Gromatou/moineau-Frame-2.5p/README.md

# moineau-Frame-2.5p — Light & Durable 2.5" FPV Frame
**(alias: how to make the PERFECT tiny FPV quad)**

## Key Features
- **Take advantage of the carbon fiber**: engineered specifically for carbon fiber mechanical properties.
- **Full component protection**: Compact structure that perfectly shields 25×25 AIOs and lite HD VTX.
- **Ultra-light**: Carbon parts weigh about 11g, and the hardware (12 screws, 4 nuts, and 4 standoffs) weighs about 2.5g.
- **Camera mount compatibility**: Fully supports all **KayouMini TPU "Camera Mounts"**.

---

## usefull guides : 
components choice guide

wich tpu is for you, and what settigns should you use to print thems

how to buy this frame, and what to ask if you want the best result

**Grognatiny** is an **original creation**. Only the dimensions of KayouMini camera TPU mounts were used to ensure perfect compatibility.

---

##  License  
This project is distributed under a CC BY-NC 4.0 license  
https://creativecommons.org/licenses/by-nc/4.0/?hl=fr-FR

The only entities authorized to resell, distribute, or use this project for commercial purposes are:

- Carbon fiber cutters on demand within the European Union
- My "alouette" shop on thrusthover.fr
(if you want to be added on this list you can ask me on discord "grognatou"
