Gromatou/moineau-Frame-2.5p/pictures/flywoo-lipo.png

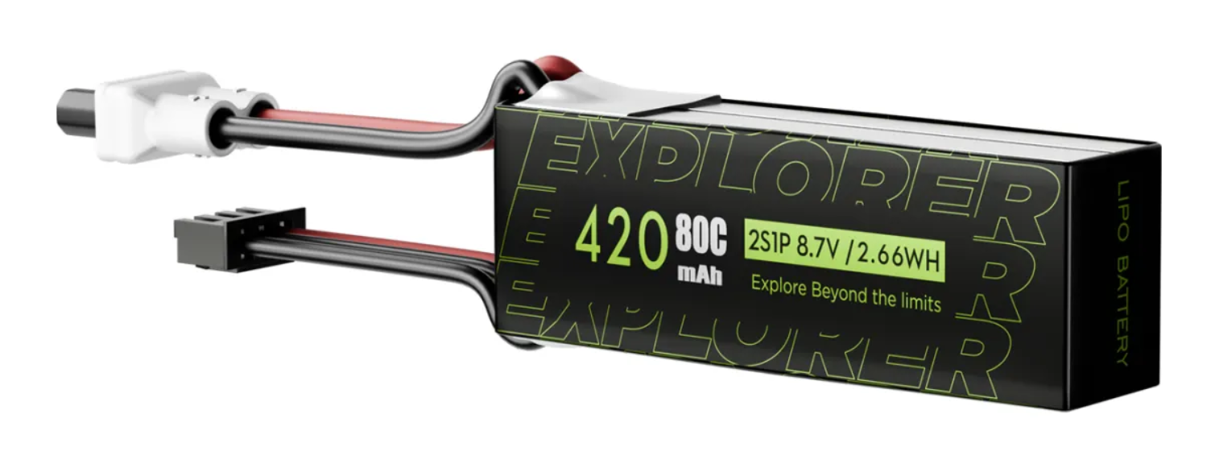
pictures/flywoo-lipo.png
