Gromatou/moineau-Frame-2.5p/pictures/GNB-lipo.png

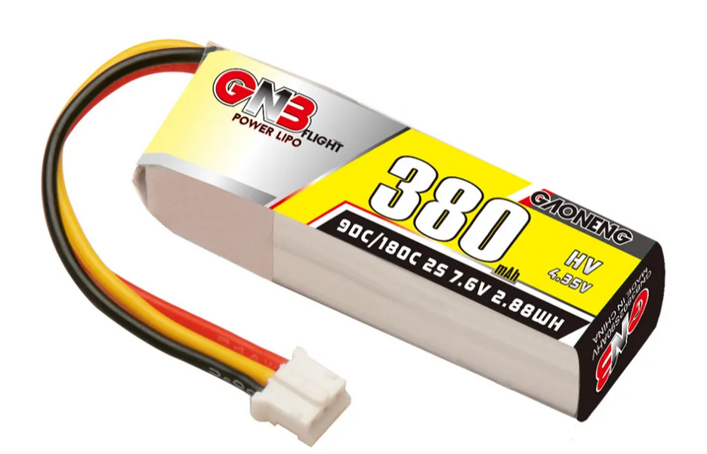
pictures/GNB-lipo.png
