Gromatou/moineau-Frame-2.5p/recommended-components.md

# Recommended Components

##  Motors  
You can choose any motor with these specs: 6500KV–9000KV, 1103  

### 22€ (4pcs) — **Surpasshobby**: 3.6g, 8000KV; good for an analog build  
surpasshobby
https://fr.aliexpress.com/item/1005008163135913.html

### 28€ (4pcs) — **Sparkhobby**: 4.5g, 8500KV; very strong, more KV, ideal for HD  
sparkhobby
https://fr.aliexpress.com/item/1005009184817863.html

### 22€ (4pcs) — **ysido**: 3.6g, 8500KV; light, cheap, widely available, but not aesthetic  
ysido
https://fr.aliexpress.com/item/1005006640914306.html

---

##  VTX, Camera & AIOs  
**Requirement:** lightweight components

###  Analog  
You can use an AIO with integrated VTX:

- **55€ — JHEMCU ELVTX**: 5g, 12A ESC, 400mW VTX; a cheap 5-in-1 AIO  
  elvtx  
  https://fr.aliexpress.com/item/1005009013813390.html

- **70€ — Ysido**: 5g, 12-20A ESC, 400mW VTX; verry good pads, clean layout, am32, blackbox  
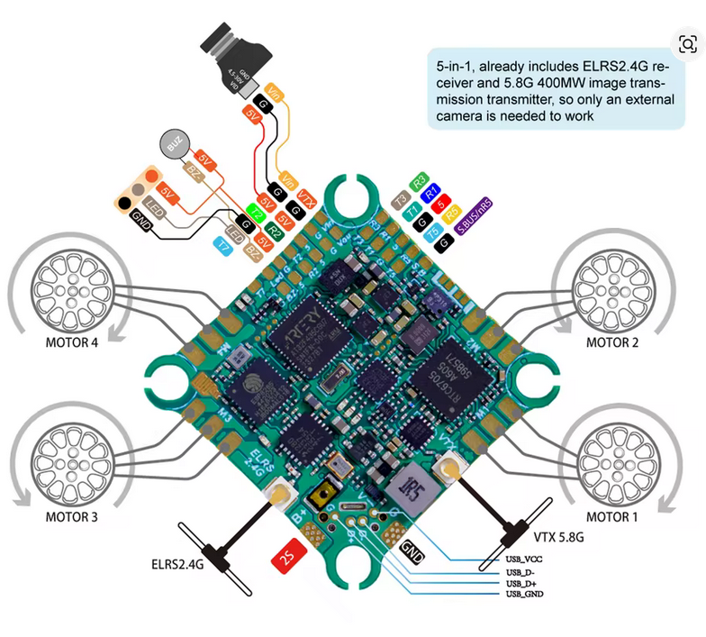
[picture p3: pictures/aio-ysido.png]
ysdio-aio
    
  https://fr.aliexpress.com/item/1005006712888748.html

- **25€ — Caddx Baby Ratel 2**: 3.5g, 165° FOV; night flight capable, best analog cam  
  bbr2  
  https://fr.aliexpress.com/item/1005009014429309.html

- **17€ — BetaFPV C03**: 1.1g, 155° FOV; save 2g and 2€, good daylight cam  
  co3  
  https://fr.aliexpress.com/item/1005007644657307.html

---

###  HDZero  
- **100€ — AIO15**: Be a goat and choose this AIO to fly like analog pilots  
  AIO15  
  https://www.hd-zero.com/product-page/hdzero-aio15

---

###  HD VTX  
You fly HD? Choose one of these VTX modules:

- **105€ — DJI O4 (lite)**: 8.5g including cam  
  o4lite  
  https://store.dji.com/fr/product/dji-o4-air-unit

- **90€ — Walksnail Avatar HD Mini**: 5.1g  
  avatar  
  https://caddxfpv.com/products/walksnail-avatar-hd-mini-1s-lite-kit

---

###  HD AIO (without integrated VTX)
You still need to stay lightweight:

- **JHEMCU ELRS**: 5g, 12A ESC, ELRS  
  jhemcu elrs  
  https://fr.aliexpress.com/item/1005007805656123.html

- **JHEMCU F435**: 5g, 20A ESC, ELRS  
  jhemcu f435  
  https://fr.aliexpress.com/item/1005007942847361.html

---

##  Battery Choices  
Which LiPo and charger should you buy?  
I realy recommand the bt3 mod on your lipos, it make them lighter, eazier to charge, and you dont carry a balance plug anymore!
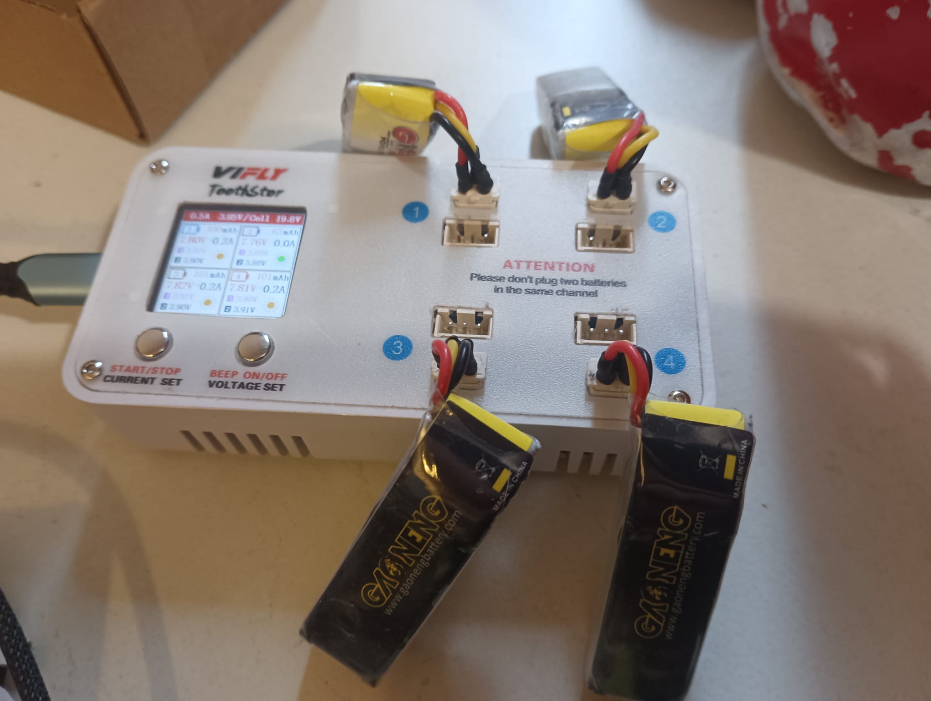
[picture p4: pictures/toothstore-bt3-GNB.jpg]
bt3 charger
    

https://www.gaoneng.shop/products/gaoneng-gnb-lihv-2s-7.6v-380mah-90c-lipo-battery-ph2.0-3pin-connector
With thoses, the bt3 mod is verry eazy to do, and they are verry cheap
