Gromatou/moineau-Frame-2.5p/frame/Bottom plate V2.dxf

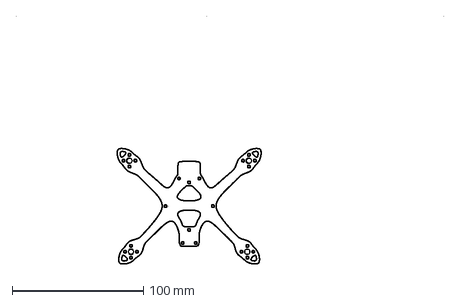
[picture p5: CAD file, 2026-05-31]
frame/Bottom plate V2.dxf
325.0 x 188.6 mm
