Gromatou/moineau-Frame-2.5p/tpu/Moineau batterystrap - alternative for xt30 lipos.3mf

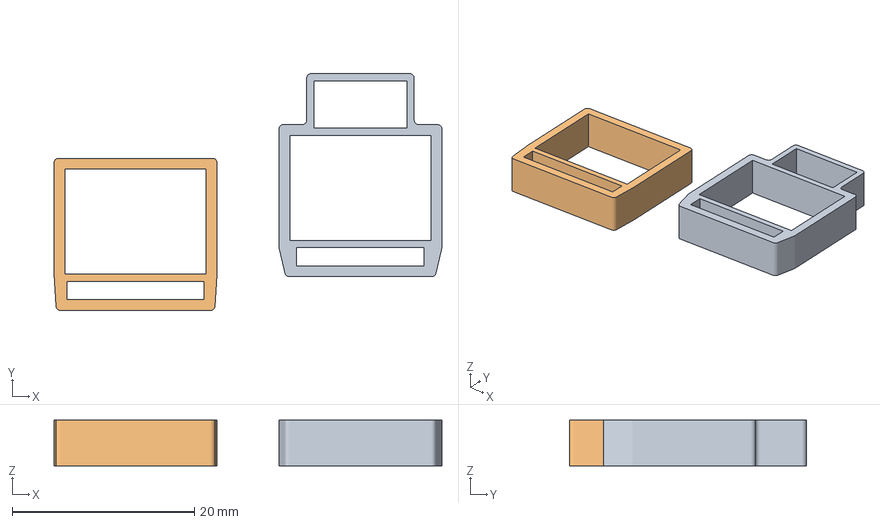
[picture p6: CAD file, 2026-07-15]
tpu/Moineau batterystrap - alternative for xt30 lipos.3mf
42.6 x 26.0 x 5.00 mm
Kayoumini batterystrap - back
Kayoumini batterystrap - front
