Gromatou/moineau-Frame-2.5p/frame/moineau-top-2mm.dxf

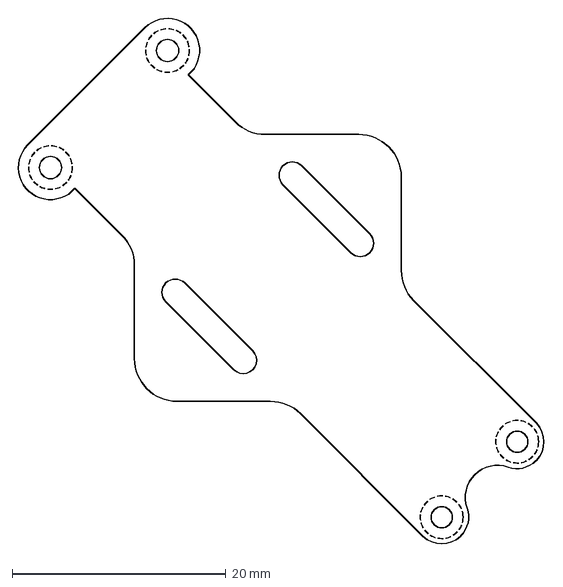
[picture p7: CAD file, 2025-12-13]
frame/moineau-top-2mm.dxf
49.6 x 49.6 mm
