Gromatou/moineau-Frame-2.5p/tpu/backback antenna inside.3mf

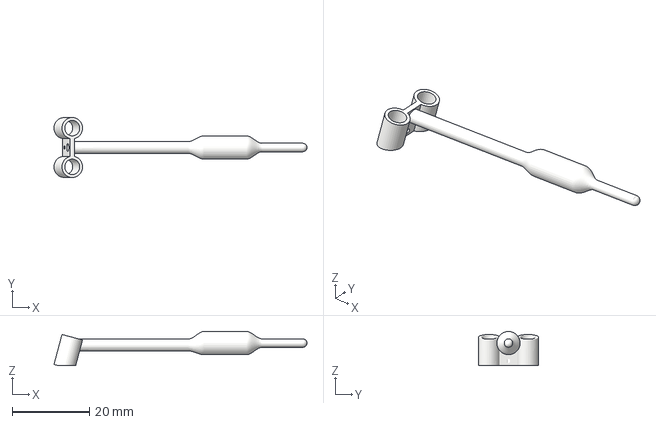
[picture p8: CAD file, 2026-06-11]
tpu/backback antenna inside.3mf
65.3 x 15.5 x 8.78 mm
