Gromatou/moineau-Frame-2.5p/tpu/backpack antenna inside bt3.3mf

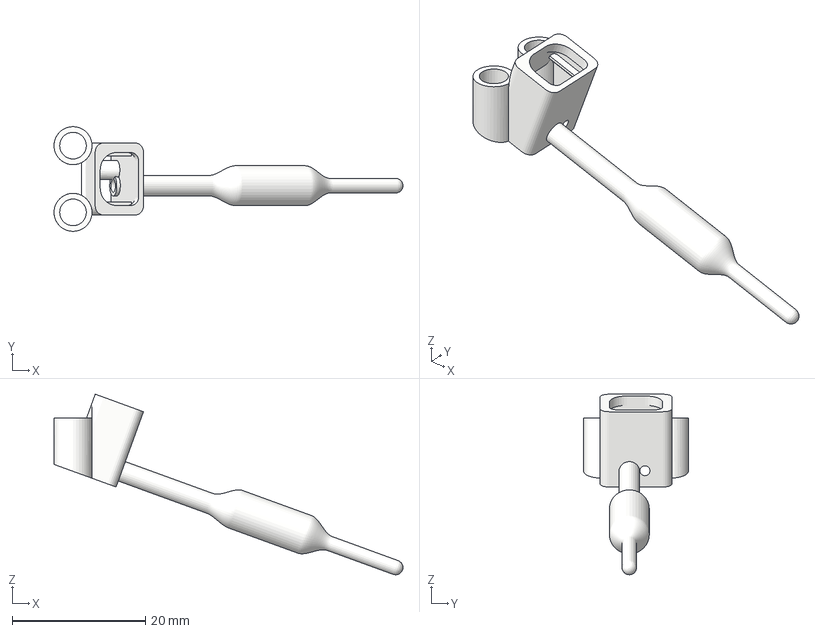
[picture p9: CAD file, 2026-06-11]
tpu/backpack antenna inside bt3.3mf
52.3 x 15.7 x 27.1 mm
