Gromatou/moineau-Frame-2.5p/tpu/Heavy Arms bumper moineau.stp

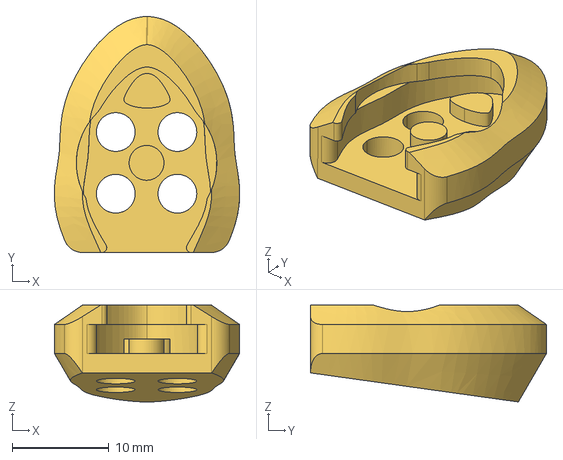
[picture p10: CAD file, 2026-06-11]
tpu/Heavy Arms bumper moineau.stp
19.1 x 24.4 x 10.0 mm
