Gromatou/moineau-Frame-2.5p/tpu/base backpack.3mf

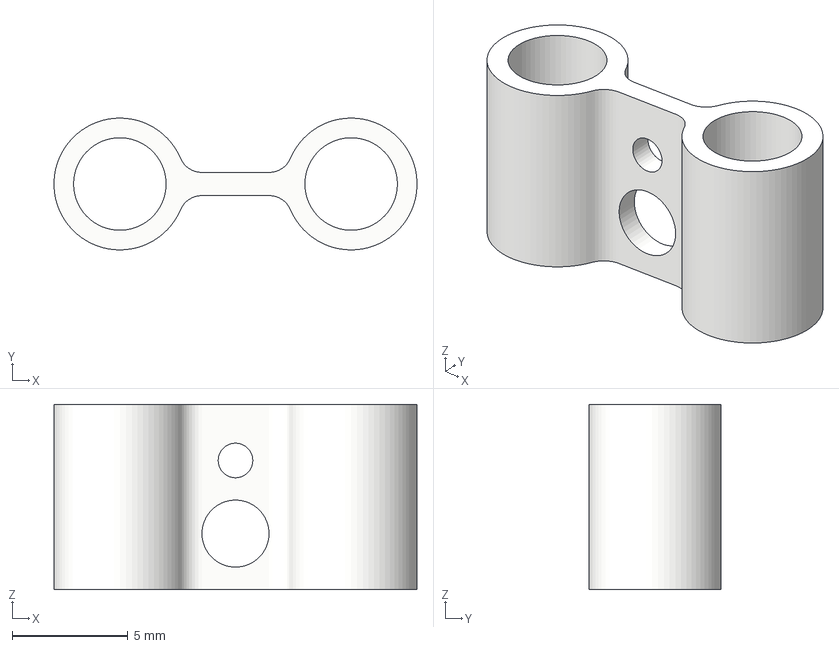
[picture p11: CAD file, 2026-05-31]
tpu/base backpack.3mf
15.7 x 5.70 x 8.00 mm
