Gromatou/moineau-Frame-2.5p/tpu/Backpack BT3 moineau.3mf

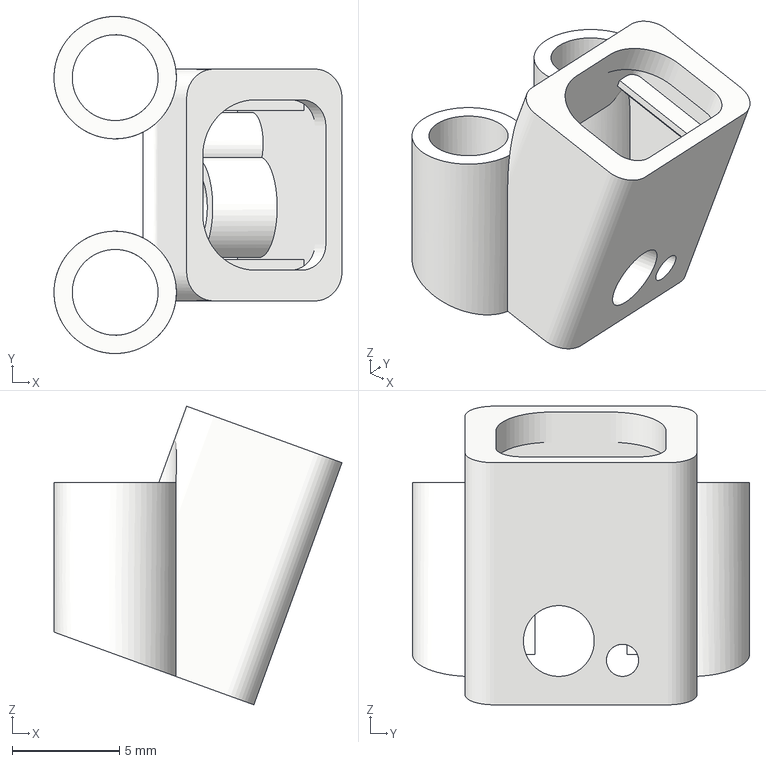
[picture p12: CAD file, 2026-05-31]
tpu/Backpack BT3 moineau.3mf
13.4 x 15.7 x 13.9 mm
