Gromatou/moineau-Frame-2.5p/tpu/Arms bumper moineau.3mf

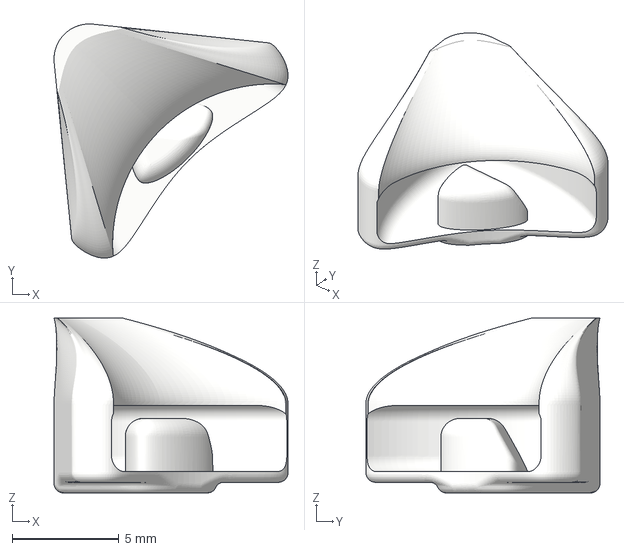
[picture p13: CAD file, 2026-05-31]
tpu/Arms bumper moineau.3mf
11.0 x 11.0 x 8.20 mm
