Gromatou/moineau-Frame-2.5p/tpu/battery strap 110% scale recommanded.3mf

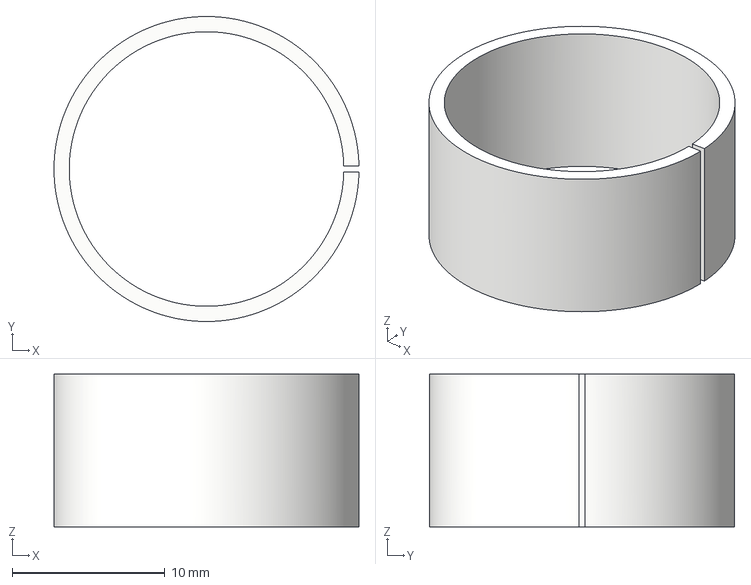
[picture p14: CAD file, 2026-02-08]
tpu/battery strap 110% scale recommanded.3mf
20.0 x 20.0 x 10.0 mm
