Gromatou/moineau-Frame-2.5p/tpu/backpack moineau.3mf

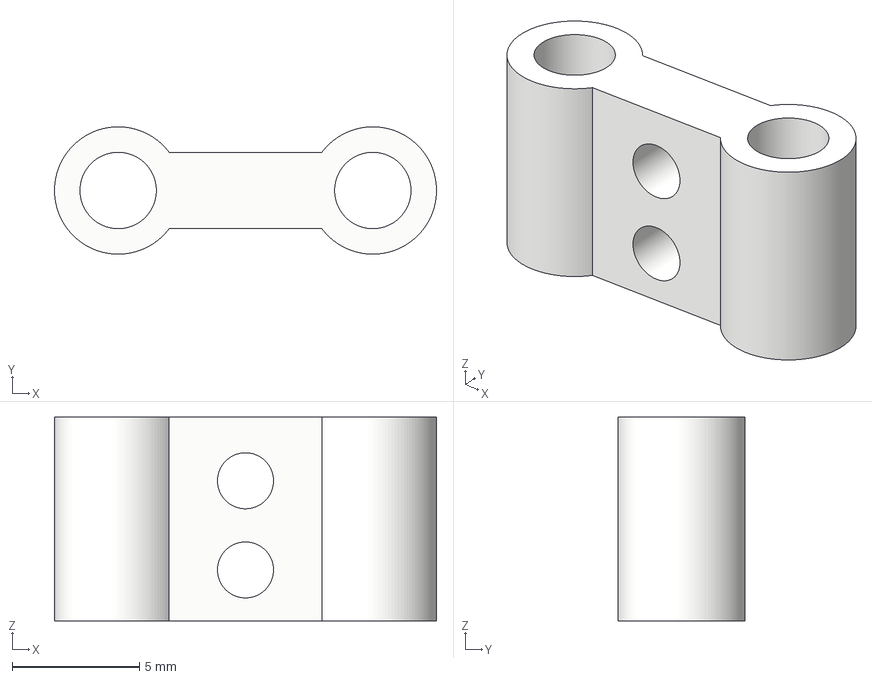
[picture p15: CAD file, 2025-12-07]
tpu/backpack moineau.3mf
15.0 x 5.00 x 8.00 mm
