Gromatou/moineau-Frame-2.5p/(commit log)

2025-12-02 Update battery choices recommendation
    Corrected recommendation for LiPo battery modification.
2025-12-03 Add carbon frame guide and update component images
    Added carbon-manufacturing-and-screws.md with frame manufacturing and screw selection instructions. Updated recommended-components.md to replace Happymodel X12 references with Ysido, adjusted motor listings, and improved battery recommendations. Added new images for Ysido AIO, GNB LiPo, Flywoo LiPo, and BT3 mod; removed Happymodel X12 image.
2025-12-07 Update and reorganize TPU 3D model files
    Added new 3D models for battery, backpack, and connector components. Removed outdated battery and backpack files, and renamed battery_350-380mah.3mf.3mf to battery_420-450mah.3mf for clarity. Updated arms bumper model.
    [350-420.3mf, arms bumper - grognatiny .3mf, arms bumper - moineau.3mf, backpack - grognatiny.3mf, backpack moineau 2 (long antenna).3mf, backpack moineau.3mf, battery-260-300.3mf, battery_280-350mah.3mf]
2025-12-07 Rename frame files to Moineau and update manufacturing instructions
    - Rename grognatiny.f3d to moineau.f3d
    - Rename bottom_plate.dxf to moineau-bottom-3mm.dxf
    - Rename top_plate.dxf to moineau-top-2mm.dxf
    - Update carbon-manufacturing-instructions.md
    [bottom_plate.dxf, grognatiny.f3d, moineau-bottom-3mm.dxf, moineau-top-2mm.dxf, moineau.f3d, top_plate.dxf]
2025-12-07 Update link to carbon manufacturing instructions
    Changed the referenced file from 'carbon-manufacturing-instructions.md' to 'carbon-manufacturing-and-screws.md' in the README to reflect updated documentation.
2025-12-07 Fix image extension and add battery product link
    Updated image file extension and added a link to a battery product.
2025-12-09 Add grognatiny frame, update top plate and backpack
    Added new grognatiny.f3z frame file. Updated top_plate.dxf with geometry and coordinate changes. Replaced backpack moineau.3mf with a new version and removed backpack moineau 2 (long antenna).3mf.
    [backpack moineau 2 (long antenna).3mf, backpack moineau.3mf, grognatiny.f3z, top_plate.dxf]
2025-12-10 Update screw and standoff recommendations
    Added recommendations for AIO 5in1 screw and standoff sizes, and emphasized weight-saving benefits of titanium screws and aluminum standoffs.
2025-12-13 better screws holes
    [moineau-top-2mm.dxf]
2026-02-08 new tpus
    [350-420.3mf, battery-260-300.3mf, battery_420-450mah.3mf, bt2 2s connector.3mf]
2026-04-03 new backpack
    [backpack-simplifié.3mf]
2026-05-31 V2 update
    V2
    [350-420.3mf, Arms bumper moineau.3mf, Backpack BT3 moineau.3mf, Bottom plate V2.dxf, arms bumper - moineau.3mf, backpack-simplifié.3mf, base backpack.3mf, battery strap 110% scale recommanded.3mf]
2026-06-11 Create Heavy Arms bumper moineau.stp
    [Heavy Arms bumper moineau.stp]
2026-06-11 added 2 backpacks with antenna inside
    [backback antenna inside.3mf, backpack antenna inside bt3.3mf]
2026-07-15 lipo strap for xt30 bigger batteries by 0x544c
    [Moineau batterystrap - alternative for xt30 lipos.3mf]
